michieltjampens/tios/core/datasheets/BLM series.jpg

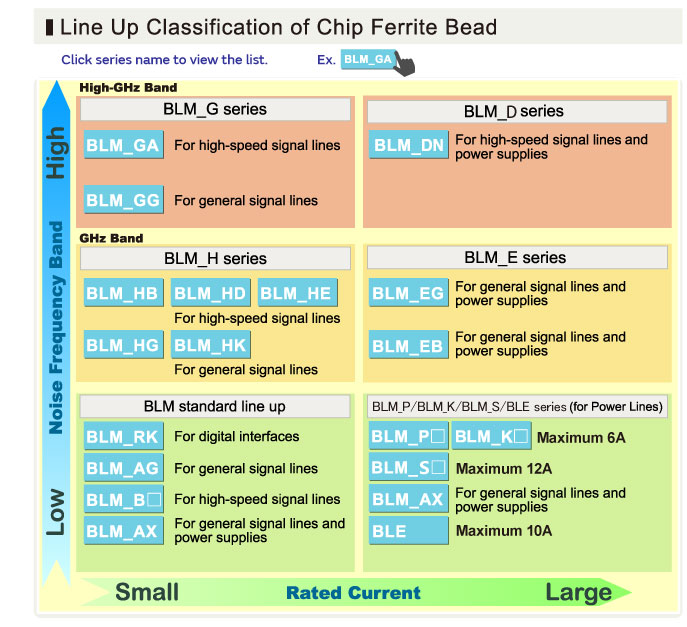
core/datasheets/BLM series.jpg
