michieltjampens/tios/core/corev2_rev0/core V2 rev0.png

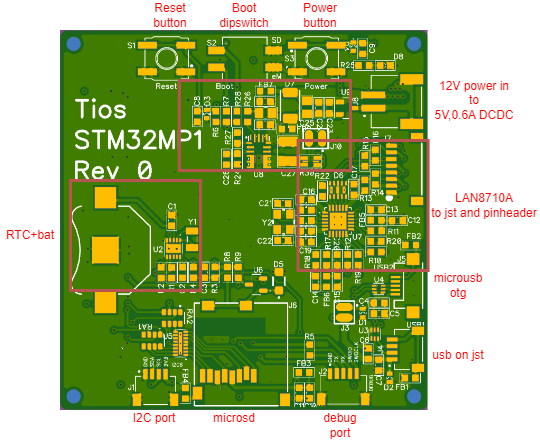
core/corev2_rev0/core V2 rev0.png
