michieltjampens/tios/core/bom_rev3.ods

Manufacturer name | Value | Name | Pattern | # | Mouser | Farnell | RefDes | 1 | 5 | 10 | 100 | Total 1 | Total 5 | Total 10 | Aisler
MYC-Y6ULY2-V2-4E512D-50-IC | imx6ull,512MB/4GB | MYC-Y6ULY2-V2 Split | MYCY6ULY2V24E512D50I | 1 | 885-CY6V24E512D50C |  | IC1 | 32,5 |  |  |  | 32,5 | 162,5 | 325 | x
ICP-20100 |  | ICP-20100 | PQFN50P200X200X85-10N | 1 |  | 3929880 | U7 | 3,98 |  | 3,11 |  | 3,98 | 19,9 | 31,1 | x
ESP-C3-13U |  | ESP-C3-13U | ESP-C3-13U | 1 |  |  | U2 | 4 | 3,24 | 3 |  | 4 | 16,2 | 30
MPM3833CGRH-Z |  | MPM3833 | QFN_2p5x3p5x1p6_MNP | 1 |  | 3818579 | U4 | 2,66 |  | 2,38 |  | 2,66 | 13,3 | 23,8 | x
CP2102N-A02-GQFN20 |  | CP2102N | IC_CP2102N-A01-GQFN20 | 1 |  |  | U1 | 2,4 |  | 2,35 |  | 2,4 | 12 | 23,5 | x
SHTC1-TR-1KS |  | SHTC1 | XDCR_SHTC1 | 1 | 403-SHTC1 | 3804223 | U9 | 3,09 |  | 2,26 |  | 3,09 | 11,3 | 22,6 | x
PCF85263ATL/AX |  | PCF85263ATL/AX | PCF85263ATL/AX | 1 | 771-PCF85263ATL/AX |  | U3 | 1,61 |  | 1,38 |  | 1,61 | 8,05 | 13,8 | x
ECLAMP2410PQTCT |  | EClamp2410P | SLP4016P16 | 1 | 947-ECLAMP2410P.TCT |  | U8 | 1,59 |  | 1,43 |  | 1,59 | 7,15 | 14,3 | x
BSR802NL6327HTSA1 |  | N Mos 20V/3,6A/17mR | SOT91P240X110-3N | 2 | 726-BSR802NL6327HTSA | 2212883 | U6, U10 |  | 0,75 | 0,65 |  | 3,76 | 6,46 | 12,92 | x
TPD2EUSB30DRTR | TPD2EUSB30 | 2-Ch ESD Protection | SOTFL35P100X50-3N | 2 |  | 3116502 | D1, D2 |  | 0,56 |  |  | 2,81 | 5,62 | 11,24 | x
USB3100-30-A | USB3100-XX-X_REVB | USB Micro Type B Rev | GCT_USB3100-XX-X_REVB | 2 | 640-USB3100-30-A | 2443125 | J1, J3 | 0,7 |  | 0,55 |  | 1,4 | 5,54 | 11,08 | x
MEM2061-01-188-00-A |  | MEM2061-01-188-00-A_REVA | GCT_MEM2061-01-188-00-A_REVA | 1 |  | 2678544 | J9 | 1,08 | 1,08 | 0,87 |  | 1,08 | 5,4 | 8,7 | x
3000TR |  | 3000TR | BAT_3000TR | 1 | 534-3000TR |  | BT1 | 0,8 | 0,80 | 0,80 |  | 0,8 | 4 | 8 | x
CM7V-T1A-32.768kHz-7pF-10PPM-TA-QC T3 (https://www.mouser.be/ProductDetail/Micro-Crystal/CM7V-T1A-32.768kHz-7pF-10PPM-TA-QC-T3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) | 32.768kHz | RTC Xtal | XTAL_CM7V-T1A_LOW_ESR | 1 | 428-201563-MG03 |  | Y1 | 0,788 |  | 0,698 |  | 0,788 | 3,94 | 6,98 | x
C2012X5R1A226M085AC | 22uF_10_20% | CAP_0805_22uF_10V | 0805 | 5 |  | 3581375 | C7, C8, C15, C18, C26 |  |  | 0,14 |  | 1,35 | 3,38 | 6,75 | x
DLP11SA900HL2L |  | DLP11SA900HL2L | DLP_0504_EXP | 2 |  | 2470369 | L1, L2 |  | 0,33 |  |  | 1,63 | 3,26 | 6,52 | x
EVQ-9P701P |  | SPST horizontal SMD switch | SW_EVQ-9P701P | 2 | 667-EVQ-9P701P |  | S1, S2 | 0,33 |  | 0,32 |  | 0,66 | 3,15 | 6,3 | x
PTVS3V3S1UR,115 | PTVS3V3S1UR | TVS Diode 3V3 Uni | SOD-123F | 1 |  | 1829253 | D6 |  | 0,48 | 0,39 |  | 2,42 | 2,42 | 3,94 | x
TCK106AF,LF |  | TCK106AF | SOT-25-5 | 1 | 757-TCK106AFLF | 3872359 | U5 |  | 0,44 | 0,36 |  | 2,18 | 2,18 | 3,6 | x
CL21B106KOQNNNE | 10uF_16V_10% | CAP_0805_10uF_16V | 0805 | 3 |  | 3013485 | C11, C14, C17 |  | 0,14 | 0,12 |  | 0,72 | 1,74 | 3,48 | x
YC164-JR-0722RL | 4x22R_5% | RES_ARRAY_22R_5% | RESCAXE80P320X160X70-8N | 18 |  | 9234411 |  |  |  | 0,04 | 0,018 | 0,74 | 1,8 | 3,24
MC0603B104K160CT | 100nF_16V_10% | CAP_0603_100nF_16V | 0603 | 6 |  | 1759016 | C2, C3, C4, C10, C13, C16 |  |  | 0,05 |  | 0,51 | 1,52 | 3,04 | x
150060RS75000 (https://be.farnell.com/wurth-elektronik/150060rs75000/led-0603-red-250mcd-625nm/dp/2322071?st=150060rs75000) | 630nm | 0603 LED Red | 0603 led | 2 |  | 2322071 | D4, D5 |  | 0,15 |  |  | 0,73 | 1,45 | 2,9 | x
EMK107ABJ475KA-T | 4.7uF_16V_10% | CAP_0603_4.7uF_16V | 0603 | 2 |  | 2112741 | C1, C19 |  |  | 0,14 |  | 1,4 | 1,4 | 2,8 | x
0402B104K160CT | 100nF_16V_10% | CAP_0402_100nF_16V | 0402 | 4 |  | 2496771 | C20, C23, C24, C25 |  |  | 0,062 |  | 0,62 | 1,24 | 2,48
SMAJ5.0CA/TR7 | SMAJ5.0CA | TVS Diode 5V | DIOM4325X250N | 1 |  | 2675312 | D3 |  | 0,29 | 0,23 |  | 1,43 | 1,43 | 2,29
MFU0603FF02000P100 | 2A | 2A Fuse 32V max | 0603 | 1 |  | 2057168 | F1 | 0,203 |  |  |  | 0,20 | 1,02 | 2,03
BLM18PG330SN1D | BLM18PG330SN1D | Ferrite 33R@100MHz | 0603 | 3 |  | 1515742 | FB3, FB5, FB6 |  |  | 0,063 |  | 0,63 | 0,95 | 1,89
HI0805P390R-10 | 39R@100MHz, 4A, HI, 8mR | HI0805P390R-10 | 0805 | 2 |  | 3605009 | E1, E2 |  |  | 0,078 |  | 0,78 | 0,78 | 1,55
0603YD105KAT2A | 1uF_16V_10% | CAP_0603_1uF_16V | 0603 | 3 |  | 1327680 | C9, C12, C21 |  |  | 0,047 |  | 0,47 | 0,71 | 1,41
MC0603N470J500CT | 47pF_50V_5% | CAP_0603_47pF_50V | 0603 | 2 |  | 1759062 | C5, C6 |  |  | 0,045 |  | 0,45 | 0,452 | 0,90
BLM18EG221SN1D | 220R@100MHz | Murata BLM18EG221SN1D ferrite | 0603 | 1 |  | 1515716 | FB4 |  |  | 0,084 |  | 0,84 | 0,84 | 0,84
BLM18PG121SN1D | 2A/0.05DCR | FB 2A | 0603 | 2 |  | 1515738 | FB1, FB2 |  |  | 0,032 |  | 0,32 | 0,32 | 0,64
C1608X7R1H103K080AA | 10nF_50V_10% | CAP_0603_10nF_50V | 0603 | 1 |  | 1907315 | C22 |  |  | 0,057 |  | 0,57 | 0,57 | 0,57
MCWR06X2212FTL | 22k1_1% | RES_0603_22k1_1% | 0603 | 1 |  | 2694776 | R1
MCMR06X1001FTL | 1k_1% | RES_0603_1k_1% | 0603 | 3 |  | 2073348 | R2, R4, R5
MCSR06X22R0FTL | 22R_1% | RES_0603_22R_1% | 0603 | 2 |  | 2074219 | R6, R8
MCWR06X1002FTL | 10k_1% | RES_0603_10k_1% | 0603 | 1 |  | 2447230 | R7
MCWR06X4701FTL | 4k7_1% | RES_0603_4k7_1% | 0603 | 2 |  | 2447385 | R9, R13
MCWR04X2003FTL | 200k_1% | RES_0603_200k_1% | 0603 | 1 |  | 2447131 | R10
MCWR06X1003FTL | 100k_1% | RES_0603_100k_1% | 0603 | 4 |  | 2447226 | R11, R12, R16, R17
CRCW060344K2FKEA. | 44k2_1% | RES_0603_44k2_1% | 0603 | 2 |  | 2138466 | R3,R14
S1751-46R |  | Ground clip | Hawin S1751-46R Ground clip | 1 | 855-S1751-46R | 2293786 | TP2
 |  |  |  |  |  |  |  |  |  |  |  | 81,1 | 311,9 | 600,2
 |  |  |  |  |  |  |  |  |  |  |  | 81,1 | 62,4 | 60,02
 |  |  |  | 93 |  |  |  |  |  |  |  | 5 | 4,5 | 3,8
 |  |  |  |  |  |  |  |  |  |  | Each | 86,1 | 66,9 | 63,8
 |  |  |  |  |  |  |  |  |  |  | PCB | 103 | 80 | 76
