michieltjampens/tios/hardware/bom.ods

# | RefDes | Name | Manufacturer | Manufacturer name | Mouser | Quantity | Price/1 | Price/10 | Price/100 |  | 1 Board | 10 | Cost | Cost 100
1 | C1, C6, C7, C8, C9, C10, C12, C13, C14, C15, C17, C18, C21, C25, C29, C33, C37, C40, C45, C46, C47, C48, C53, C55, C56, C57, C58, C59, C61, C62, C63, C65, C66, C76 | CAP_0402_100nF_16V | Walsin | 0402B104K160CT | 791-0402B104K160CT | 34 | 0,108 | 0,017 | 0,01 |  | 0,578 | 340 | 3,4 |  | 1,35%
2 | C2, C38 | CAP_0402_2.2uF_6V3 | Taiyo Yuden | MSASJ105SB5225KF | 963-MSASJ105SB5225KF | 2 | 0,093 | 0,032 | 0,017 |  | 0,186 | 20 | 0,64 | 1,7 | 0,25%
3 | C3, C4, C20, C49 | CAP_0402_1nF_50V | Taiyo Yuden | MBASU105SB7102KFNA18 | 963-MBASU105SB7102KF | 4 | 0,093 | 0,025 | 0,013 |  | 0,372 | 40 | 1 | 1,3 | 0,40%
4 | C5, C11, C64 | CAP_0603_10uF_10V | Murata | GRM188R61A106ME69D | 81-GRM188R61A106ME9D | 3 | 0,13 | 0,048 | 0,028 |  | 0,39 | 30 | 1,44 | 2,8 | 0,57%
5 | C16, C19 | CAP_0402_4.7uF_6V3 | Samsung | CL05A475KQ5NRNC | 187-CL05A475KQ5NRNC | 2 | 0,093 | 0,03 | 0,02 |  | 0,186 | 20 | 0,6 | 2 | 0,24%
6 | C22, C26, C30, C34 | CAP_0603_10uF_16V | Kyocera AVX | CM105X5R106K16AT | 581-CM105X5R106K16AT | 4 | 0,223 | 0,104 | 0,062 |  | 0,892 | 40 | 4,16 | 6,2 | 1,65%
7 | C23, C27, C31, C35 | CAP_0402_3.6pF_25V | muRata | GRM1555C1E3R6BA01D | 81-GRM1555C1E3R6BA1D | 4 | 0,093 | 0,047 | 0,021 |  | 0,372 | 40 | 1,88 | 2,1 | 0,74%
8 | C24, C28, C32, C36, C60 | CAP_0603_22uF_6V3 | Murata | GRM188R60J226MEA0D | 81-GRM188R60J226ME0D | 5 | 0,14 | 0,057 | 0,04 |  | 0,7 | 50 | 2,85 | 4 | 1,13%
9 | C39, C67, C68, C69, C70, C72 | CAP_0402_1uF_16V | Taiyo Yuden | MCASE105SB5105KFNA01 | 963-MCASE105SB5105KF | 6 | 0,093 | 0,033 | 0,017 |  | 0,558 | 60 | 1,98 | 1,7 | 0,78%
10 | C41, C42 | CAP_0402_16pF_50V | Yageo | CC0402JRNPO9BN160 | 603-CC402JRNPO9BN160 | 2 | 0,093 | 0,02 | 0,011 |  | 0,186 | 20 | 0,4 | 1,1 | 0,16%
11 | C43, C44 | CAP_0402_30pF_25V | Walsin | 0402N300J250CT | 791-0402N300J250CT | 2 | 0,108 | 0,016 | 0,009 |  | 0,216 | 20 | 0,32 | 0,9 | 0,13%
12 | C50, C52, C54 | CAP_0603_22uF_10V | Murata | GRM188R61A226ME15J | 81-GRM188R61A226ME5J | 3 | 0,186 | 0,124 | 0,062 |  | 0,558 | 30 | 3,72 | 6,2 | 1,47%
13 | C51 | CAP_0402_2.2nF_25V | Murata | GRM155R61E222KA01D | 81-GRM155R61E222KA1D | 1 | 0,093 | 0,017 | 0,007 |  | 0,093 | 10 | 0,17 | 0,7 | 0,07%
14 | C71, C74, C75 | CAP_0402_10nF_25V | Walsin | MG15B103K250CT | 791-MG15B103K250CT | 3 | 0,108 | 0,01 | 0,005 |  | 0,324 | 30 | 0,3 | 0,5 | 0,12%
15 | C73 | CAP_0402_470nF_16V | Taiyo Yuden | EMK105ABJ474KV-F | 963-EMK105ABJ474KV-F | 1 | 0,102 | 0,044 | 0,022 |  | 0,102 | 10 | 0,44 | 2,2 | 0,17%
16 | D1 | ESD Suppressor USB | ST | ESDA7P120-1U1M | 511-ESDA7P120-1U1M | 1 | 0,4 | 0,273 | 0,188 |  | 0,4 | 10 | 2,73 | 18,8 | 1,08%
17 | ED1, ED2, ED3, ED4, ED5 | ESD 0402 3V3 | NXP | PESD3V3L1BSL | 771-PESD3V3L1BSLZ | 5 | 0,093 | 0,07 | 0,038 |  | 0,465 | 50 | 3,5 | 3,8 | 1,39%
18 | FB1, FB2 | Ferrite 120R@100MHz, 2A | muRata | BLM18PG121SN1D | 81-BLM18PG121SN1D | 2 | 0,167 | 0,137 | 0,076 |  | 0,334 | 20 | 2,74 | 7,6 | 1,08%
19 | FB3 | Ferrite 220R@100MHz, 2A | Murata | BLM18EG221SN1D | 81-BLM18EG221SN1D | 1 | 0,195 | 0,11 | 0,099 |  | 0,195 | 10 | 1,1 | 9,9 | 0,44%
20 | FB4, FB5, FB6 | Ferrite 33R@100MHz, 3A | Murata | BLM18PG330SN1D | 81-BLM18PG330SN1D | 3 | 0,093 | 0,06 | 0,033 |  | 0,279 | 30 | 1,8 | 3,3 | 0,71%
21 | J1 | USB Micro Type B Rev | GCT | USB3100-30-A | 640-USB3100-30-A | 1 | 0,651 | 0,492 | 0,431 |  | 0,651 | 10 | 4,92 | 43,1 | 1,95%
22 | J2 | tiny usd slot | Molex | 47571-0001 | 538-47571-0001 | 1 | 0,632 | 0,558 | 0,558 |  | 0,632 | 10 | 5,58 | 55,8 | 2,21%
26 | L1, L2, L3, L4 | DFE252012F-1R0M=P2 | muRata | DFE252012F-1R0MP2 | 81-DFE252012F-1R0MP2 | 4 | 0,316 | 0,206 | 0,196 |  | 1,264 | 40 | 8,24 | 19,6 | 3,26%
27 | R1, R39, R40, R54 | RES_0402_100R_1% | Yageo | RC0402FR-7W100RL | 603-RC0402FR-7W100RL | 4 | 0,093 | 0,015 | 0,007 |  | 0,372 | 40 | 0,6 | 0,7 | 0,24%
28 | R2, R10, R14, R17, R20, R23, R24, R26, R28, R41, R42, R51, R52, R55, R59, R60 | RES_0402_10k_1% | Yageo | RC0402FR-0710KL | 603-RC0402FR-0710KL | 16 | 0,093 | 0,008 | 0,005 |  | 0,128 | 160 | 1,28 |  | 0,51%
29 | R3 | RES_0402_240R_1% | Walsin | WR04X2400FTL | 791-WR04X2400FTL | 1 | 0,108 | 0,008 | 0,003 |  | 0,108 | 10 | 0,08 | 0,3 | 0,03%
30 | R4, R5, R11 | RES_0402_1k_1% | Yageo | RC0402FR-101KL | 603-RC0402FR-101KL | 3 | 0,093 | 0,008 | 0,005 |  | 0,279 | 30 | 0,24 | 0,5 | 0,09%
31 | R6, R18 | RES_0402_124k_1% | Yageo | RC0402FR-07124KL | 603-RC0402FR-07124KL | 2 | 0,093 | 0,008 | 0,005 |  | 0,186 | 20 | 0,16 | 0,5 | 0,06%
32 | R7, R25, R31, R32, R33, R34, R35, R36, R50, R53 | RES_0402_22R_1% | Walsin | WR04X22R0FTL | 791-WR04X22R0FTL | 10 | 0,108 | 0,006 | 0,003 |  | 0,06 | 100 | 0,3 | 0,3 | 0,12%
33 | R8, R9, R13, R16, R19, R22 | RES_0402_100k_1% | Yageo | RC0402FR-13100KL | 603-RC0402FR-13100KL | 6 | 0,093 | 0,008 | 0,005 |  | 0,558 | 60 | 0,48 | 0,5 | 0,19%
34 | R12, R21 | RES_0402_66k5_1% | Yageo | AC0402FR-0766K5L | 603-AC0402FR-0766K5L | 2 | 0,093 | 0,011 | 0,007 |  | 0,186 | 20 | 0,22 | 0,7 | 0,09%
35 | R15 | RES_0402_453k_1% | Yageo | RC0402FR-07453KL | 603-RC0402FR-07453KL | 1 | 0,093 | 0,008 | 0,005 |  | 0,093 | 10 | 0,08 | 0,5 | 0,03%
36 | R27 | RES_0402_0R | Vishay | CRCW04020000Z0EDC | 71-CRCW04020000Z0EDC | 1 | 0,093 | 0,012 | 0,007 |  | 0,093 | 10 | 0,12 | 0,7 | 0,05%
37 | R29, R30 | RES_0402_1R_1% | Walsin | WR04W1R00FTL | 791-WR04W1R00FTL | 2 | 0,108 | 0,01 | 0,004 |  | 0,216 | 20 | 0,2 | 0,4 | 0,08%
38 | R37, R38 | RES_0402_10R_1% | Yageo | AC0402FR-0710RL | 603-AC0402FR-0710RL | 2 | 0,093 | 0,013 | 0,07 |  | 0,186 | 20 | 0,26 | 7 | 0,10%
39 | R43 | RES_0402_12k_1% | Yageo | RC0402FR-0712KL | 603-RC0402FR-0712KL | 1 | 0,093 | 0,008 | 0,005 |  | 0,093 | 10 | 0,08 | 0,5 | 0,03%
40 | R44 | RES_0402_1k5_1% | Walsin | WR04X1501FTL | 791-WR04X1501FTL | 1 | 0,108 | 0,006 | 0,003 |  | 0,108 | 10 | 0,06 | 0,3 | 0,02%
41 | R45 | RES_0402_33R_1% | Yageo | RC0402FR-0733RL | 603-RC0402FR-0733RL | 1 | 0,093 | 0,008 | 0,005 |  | 0,093 | 10 | 0,08 | 0,5 | 0,03%
42 | R46, R47, R48, R49 | RES_0402_49R9_1% | Vishay | RCC040249R9FKED | 71-RCC040249R9FKED | 4 | 0,102 | 0,051 | 0,023 |  | 0,408 | 40 | 2,04 | 2,3 | 0,81%
43 | R56, R57 | RES_0402_470R_1% | TE Connectivity | CRGCQ0402F470R | 279-CRGCQ0402F470R | 2 | 0,093 | 0,013 | 0,006 |  | 0,186 | 20 | 0,26 | 0,6 | 0,10%
44 | R58, R62, R63 | RES_0402_133R_1% | Yageo | RC0402FR-07133RL | 603-RC0402FR-07133RL | 3 | 0,093 | 0,008 | 0,005 |  | 0,279 | 30 | 0,24 | 0,5 | 0,09%
45 | R61 | RES_0402_18k_1% | Yageo | RC0402JR-1318KL | 603-RC0402JR-1318KL | 1 | 0,093 | 0,014 | 0,007 |  | 0,093 | 10 | 0,14 | 0,7 | 0,06%
49 | U2 | EMMC16G-MW28-01E10 | Kingston Technology | EMMC16G-MW28-01E10 | 524-EMMC16GMW2801E10 | 1 | 5,82 | 5,79 | 5,79 |  | 5,82 | 10 | 57,9 |  | 22,92%
50 | U3 | 4Gb DDR3L ram | Kingston | D2516ECMDXGJDI-U | 524-D2516ECMDXGJDI-U | 1 | 2,88 | 2,86 | 2,86 |  | 2,88 | 10 | 28,6 |  | 11,32%
51 | U4, U7 | TPS62A02 | Texas Instruments | TPS62A02DRLR | 595-TPS62A02DRLR | 2 | 0,409 | 0,303 | 0,19 |  | 0,818 | 20 | 6,06 |  | 2,40%
52 | U5 | usd esd pu | Semtech | ECLAMP2410PQTCT | 947-ECLAMP2410P.TCT | 1 | 1,26 | 1,05 | 0,839 |  | 1,26 | 10 | 10,5 |  | 4,16%
53 | U6 | N-Channel 20V 3.7A | Infineon | BSR802NL6327HTSA1 | 726-BSR802NL6327HTSA | 1 | 0,512 | 0,445 | 0,327 |  | 0,512 | 10 | 4,45 |  | 1,76%
54 | U8, U9 | TPS62A01 | Texas Instruments | TPS62A01DRLR | 595-TPS62A01DRLR | 2 | 0,409 | 0,3 | 0,171 |  | 0,818 | 20 | 6 |  | 2,37%
55 | U10 | TLV75518PDBVR | Texas Instruments | TLV75518PDBVR | 595-TLV75518PDBVR | 1 | 0,372 | 0,296 | 0,22 |  | 0,372 | 10 | 2,96 |  | 1,17%
56 | U11 | LAN8720A-CP | Microchip | LAN8720A-CP-TR-ABC | 579-LAN8720ACPTRABC | 1 | 1,2 | 1,2 | 1,2 |  | 1,2 | 10 | 12 |  | 4,75%
57 | U12, U13 | USB2 ESD+Choke | ST | ECMF02-2AMX6 | 511-ECMF02-2AMX6 | 2 | 0,484 | 0,348 | 0,25 |  | 0,968 | 20 | 6,96 |  | 2,75%
58 | Y1 | 24MHz 18pF | ECS | ECS-240-18-33B-7KM-TR | 520-240-18-33B-7KM-T | 1 | 0,288 | 0,242 | 0,242 |  | 0,288 | 10 | 2,42 |  | 0,96%
59 | Y2 | 25MHz XTAL | ECS | ECS-250-8-33B-CKM | 520-ECS250833BCKM-TR | 1 | 0,428 | 0,318 | 0,283 |  | 0,428 | 10 | 3,18 |  | 1,26%
60 | U1 | RK3308B | Rockchip | RK3308B |  | 1 | 5,08 | 5,08 | 5,08 |  | 5,08 | 10 | 50,8 |  | 20,11%
 |  |  |  |  |  |  |  |  |  | Total | € 34,10 |  | € 252,66
 |  |  |  |  |  |  |  |  |  | Per Board | € 34,10 |  | € 25,27
