michieltjampens/tios/(threads)

Thread 1 (2022-07-17):

Rev 2 Testing

michieltjampens, 2022-07-17:
**Build Rev 2**
- [x] Received board (eta 27/7/2022)
- [ ] Order new components (sensors & caps)
- [ ] PCBA all 94 components... (hurray for stencil + heated build plate + paste)

**Test prep (assumes that stuff working in rev1 still work)**
- [x] Install u-boot,kernel and rootfs via usb client

**Component testing**
- [x] Check if USB->UART works
- [ ] Check if µSD issue is fixed
- [ ] Check if RTC works on battery (waiting for delivery)
- [x]  Check if temp/hum is found on bus
  - [x] Write dcafs code for it
- [x]  Check if temp/press is found on bus
  - [x] Alter DTS to include the int pin
  - [x] Write dcafs code for it
- [ ]  Check if SPI connection to ESP32-C3 works
  - [ ] Recompile kernel to add required support
  - [ ] Check if Wifi/BLE work
- [x]  Check if ethernet works (fec1)
- [ ] Check if USB host works

michieltjampens, 2022-08-10:
Burned out SoM on trying to remove the RTC...

Closed 2024-03-15.
