michieltjampens/tios/core/core_v1_schematic.pdf

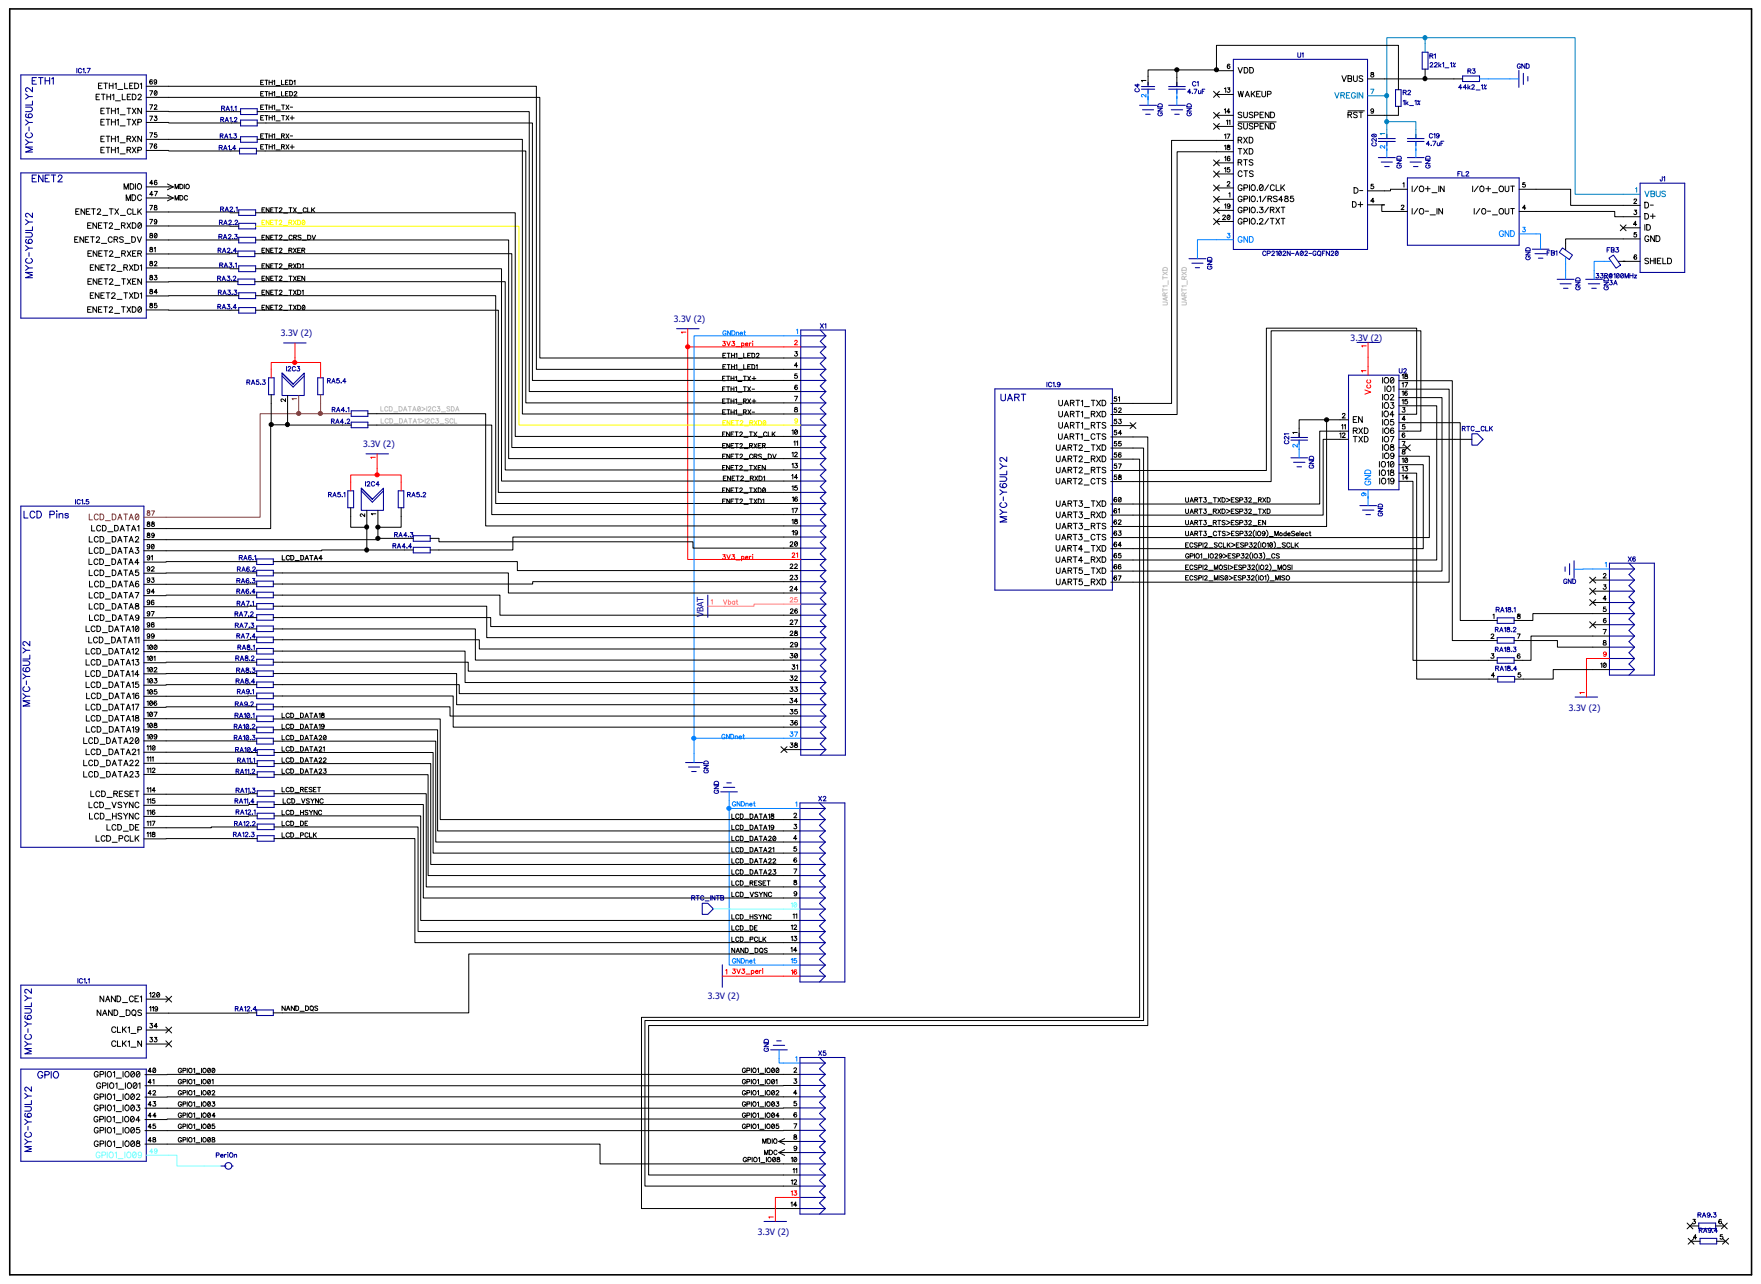
[picture p3: page 1]
VBAT

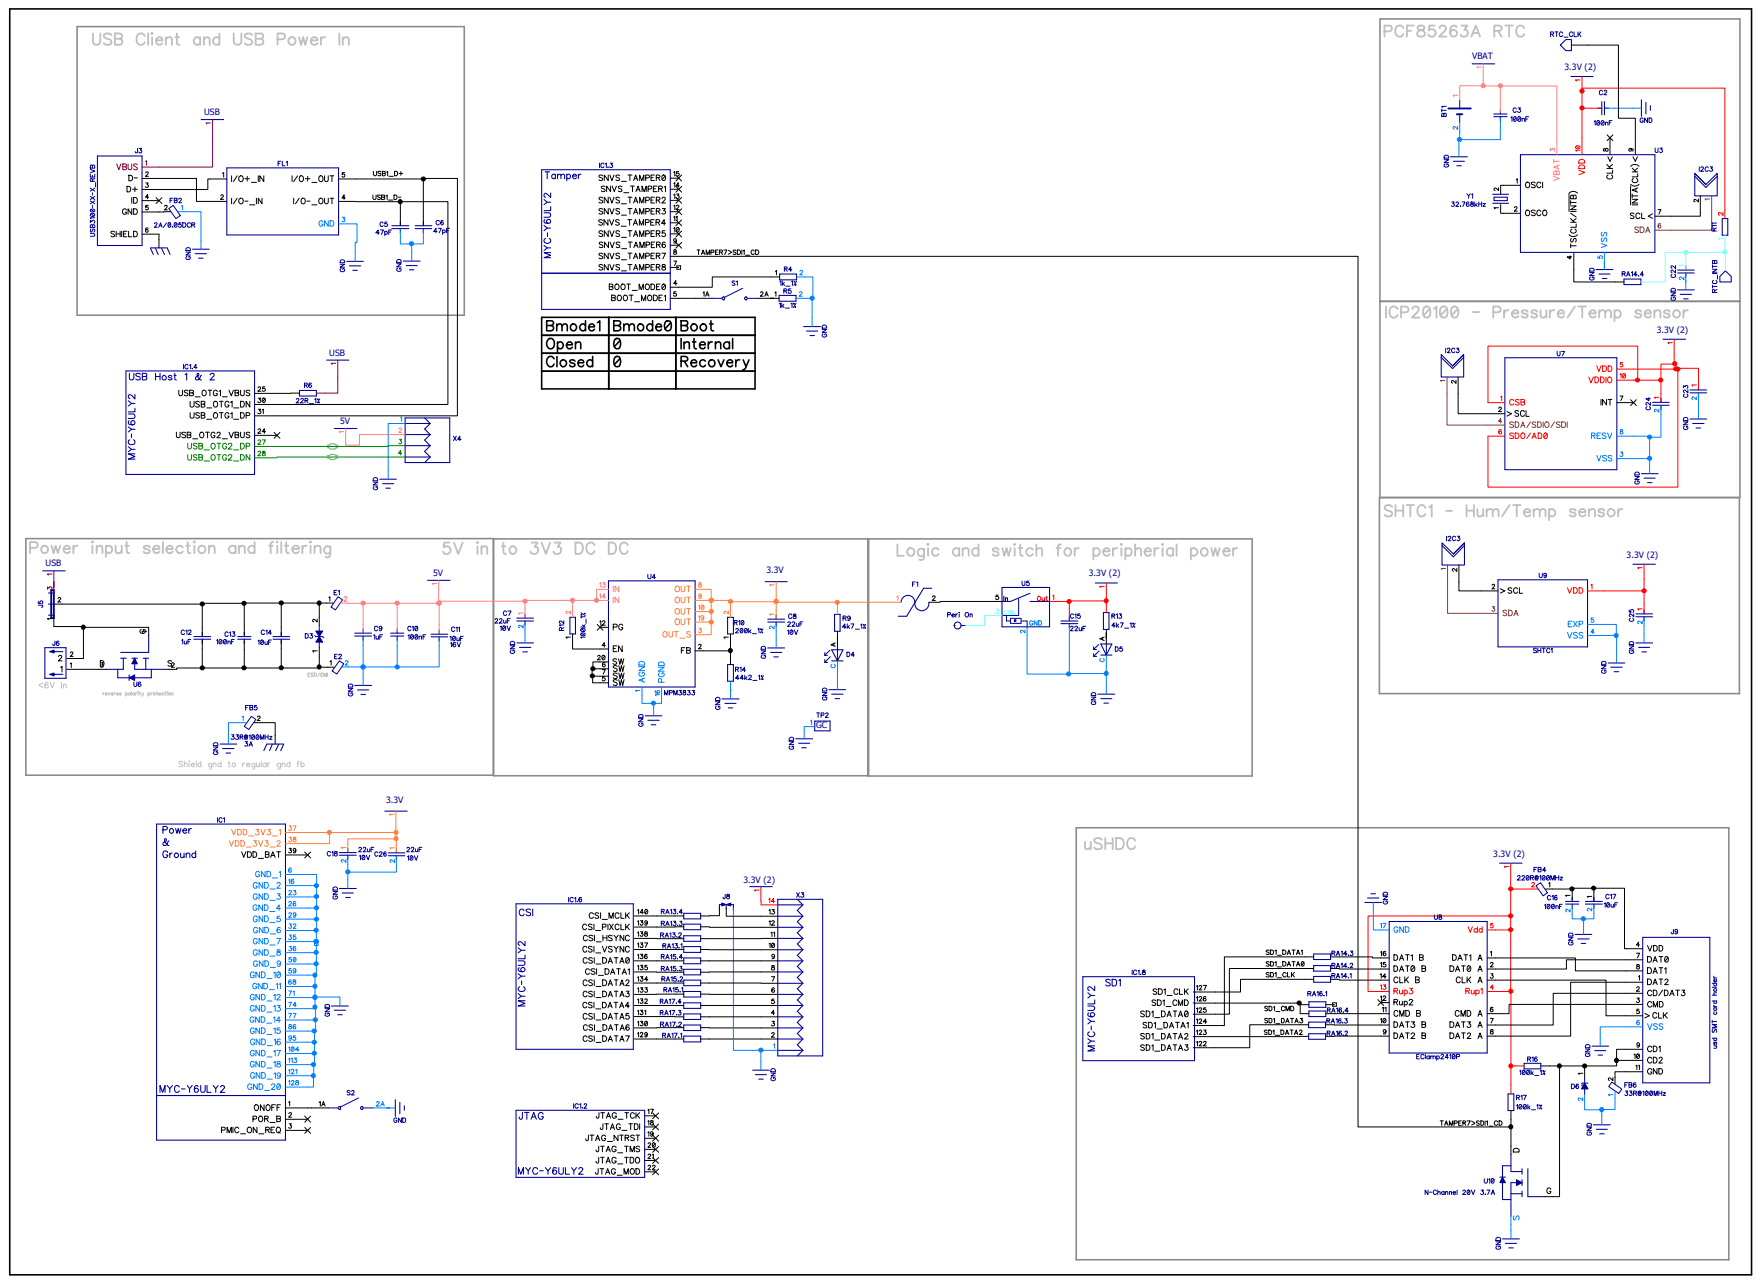
[picture p4: page 2]
VBAT; USB
