michieltjampens/tios/core/corev2_rev0/core_v2rev0_schematic.pdf

## VBAT

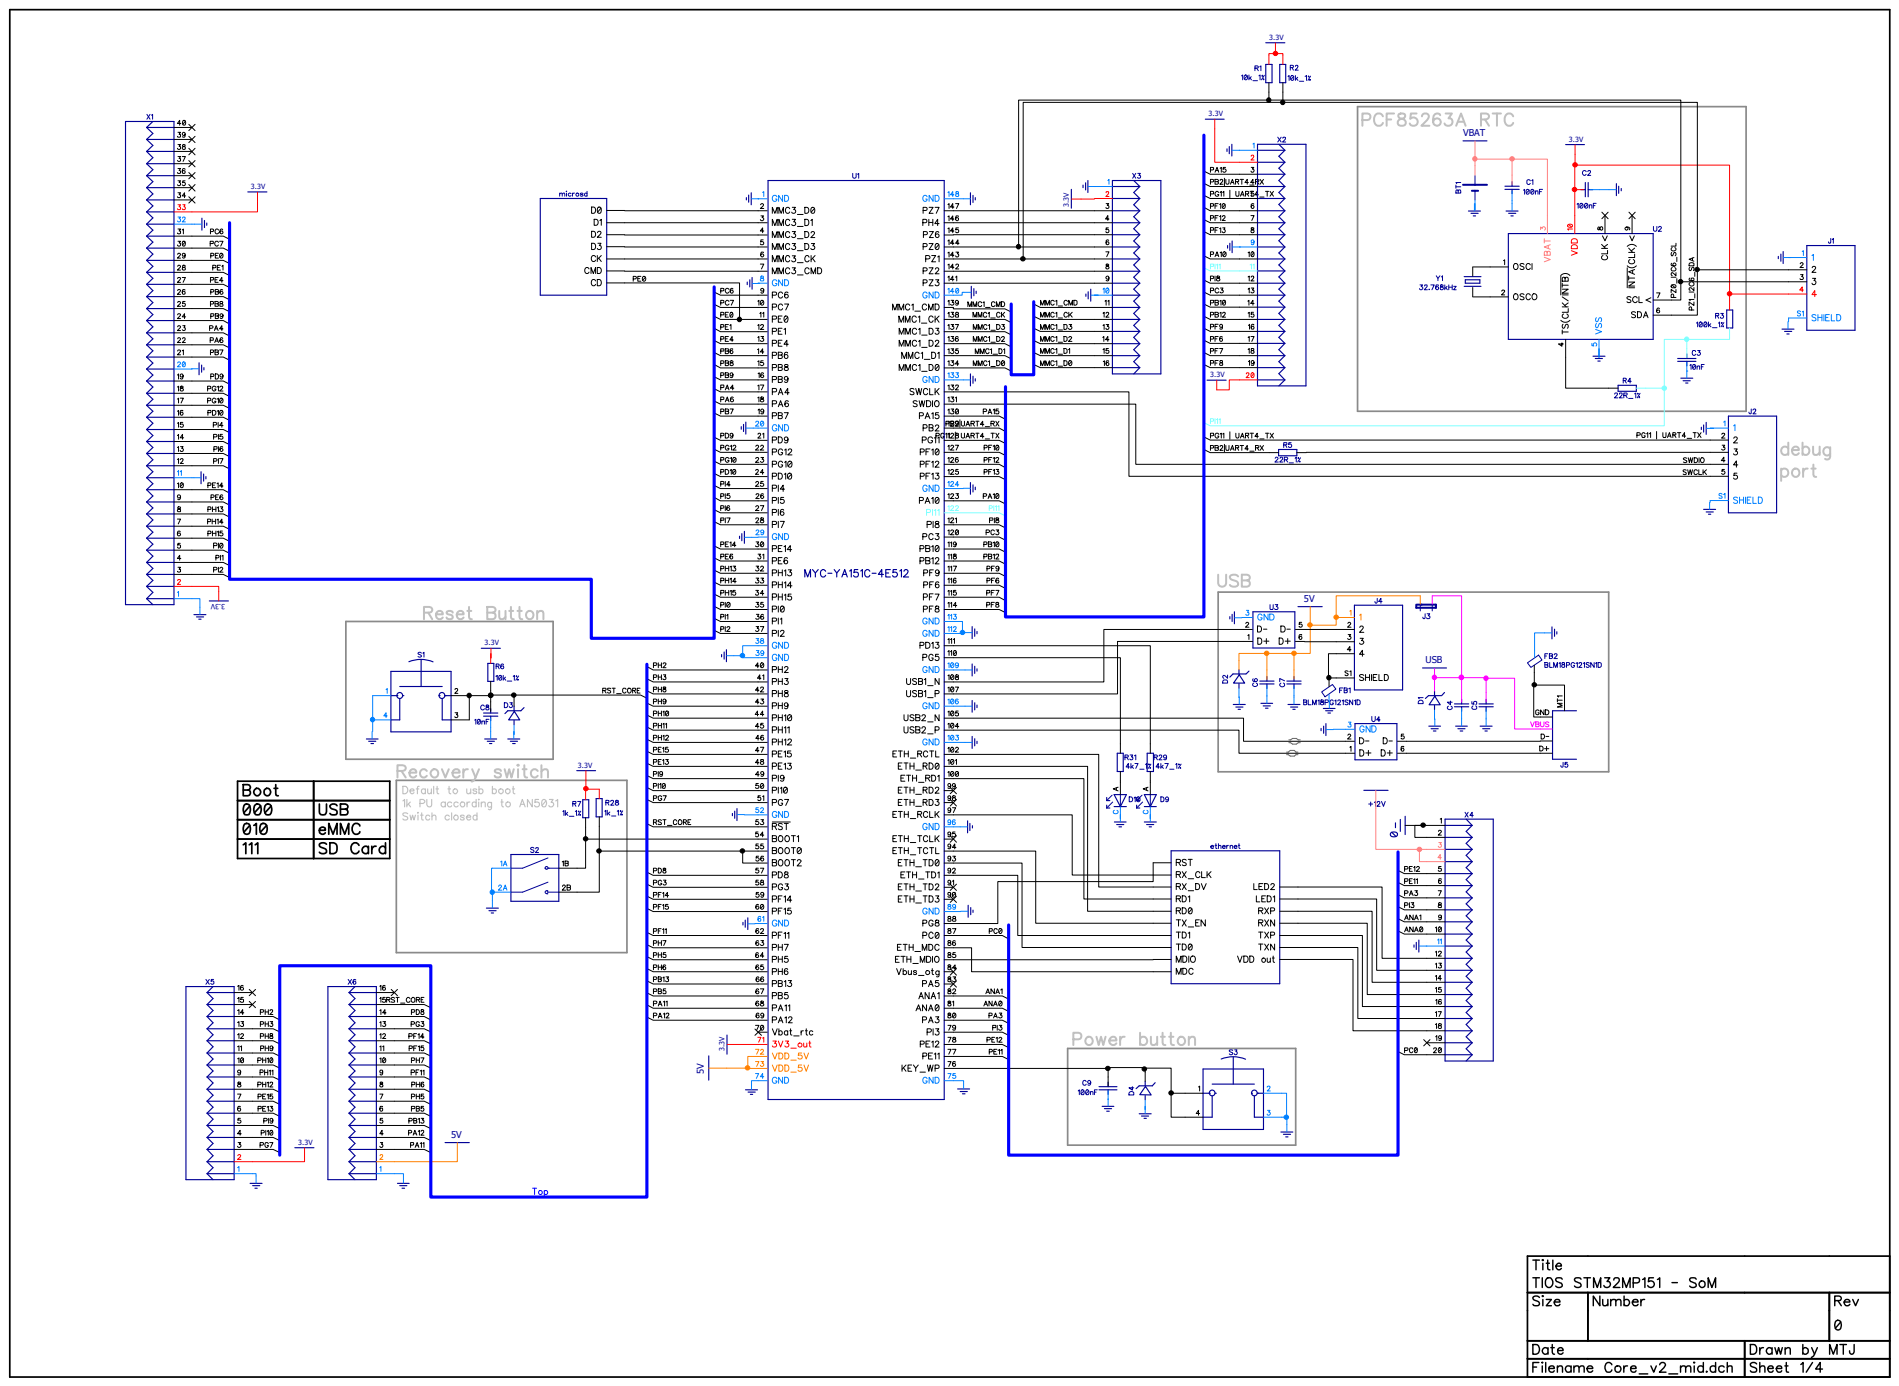
[picture p5: page 1]
USB

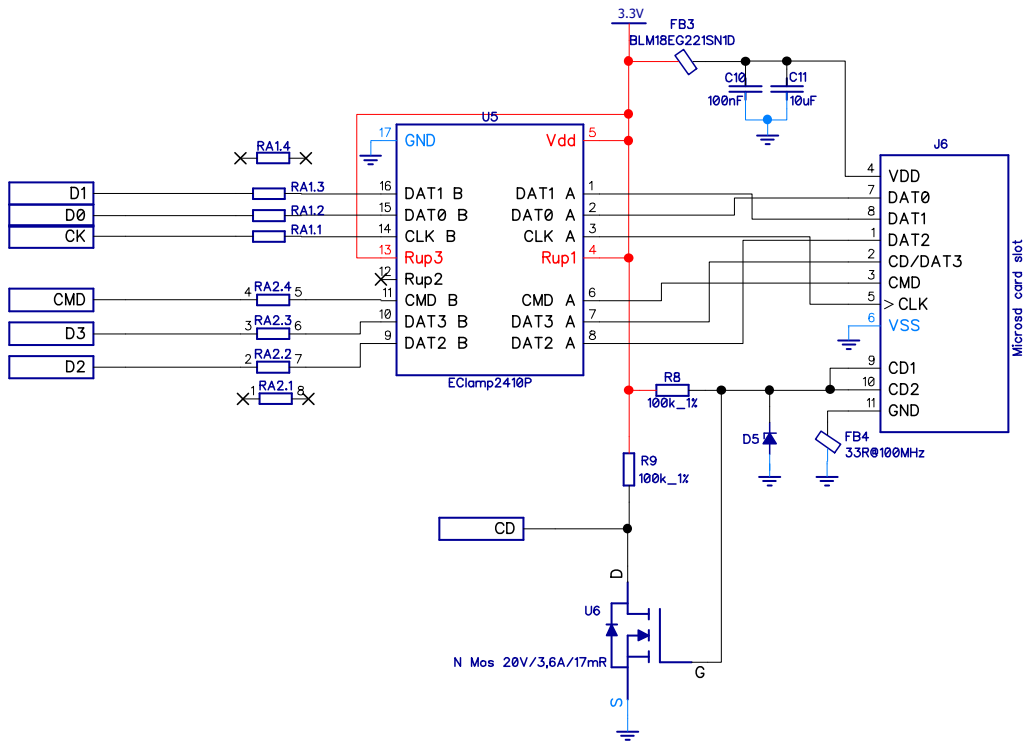
[picture p6: page 2]

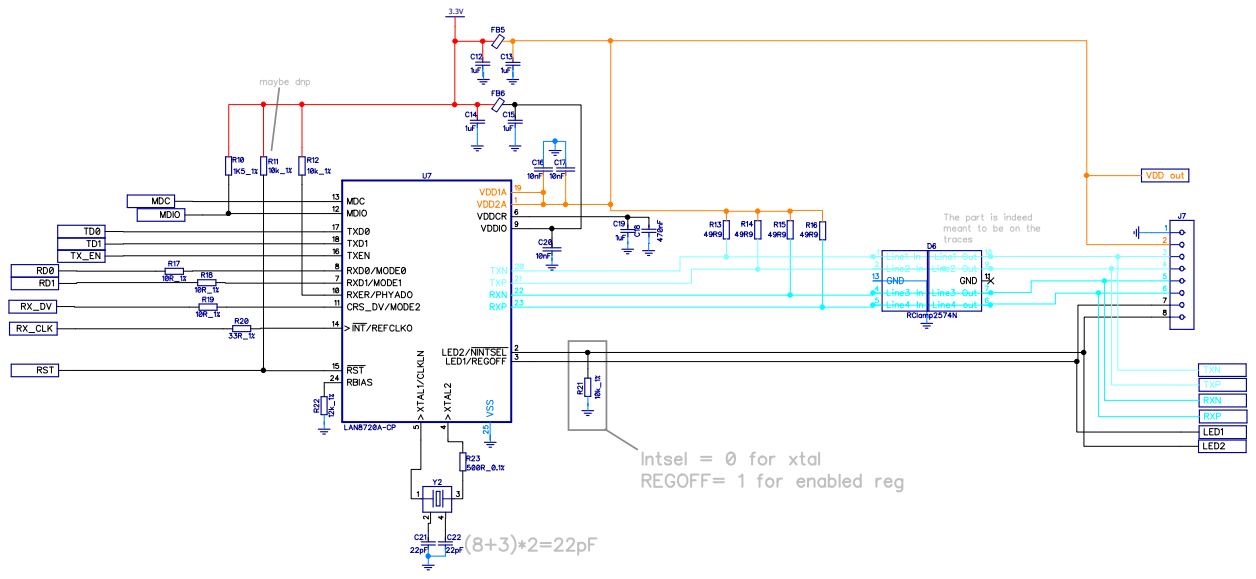
[picture p7: page 3]

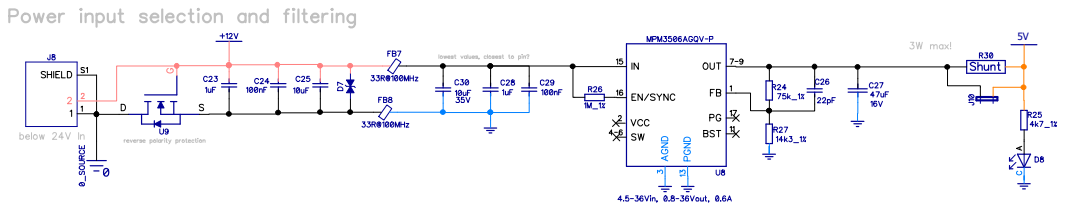
[picture p8: page 4]
