michieltjampens/tios/(list of files, drawings)

Other design files:
core/Core_v1.dch
core/Core_v1.dip
core/Core_v2.dip
core/corev2_rev0/Core_v2 - rev0.dch
core/corev2_rev0/Core_v2 - rev0.dip
hardware/tios v1.dch
hardware/tios v1.dip
