michieltjampens/tios/core/code/cubemx/tios.ioc

Mcu.UserName=STM32MP151AACx
PA1.Signal=ETH1_REF_CLK
PA10.Signal=USB_OTG_HS_ID
PA2.Signal=ETH1_MDIO
PA7.Signal=ETH1_CRS_DV
PA8.Signal=SDMMC2_D4
PA9.Signal=SDMMC2_D5
PB11.Signal=ETH1_TX_EN
PB15.Signal=SDMMC2_D1
PB2.Signal=UART4_RX
PB3.Signal=SDMMC2_D2
PB4.Signal=SDMMC2_D3
PC1.Signal=ETH1_MDC
PC10.Signal=SDMMC1_D2
PC14-OSC32_IN.Signal=RCC_OSC32_IN
PC15-OSC32_OUT.Signal=RCC_OSC32_OUT
PC4.Signal=ETH1_RXD0
PC5.Signal=ETH1_RXD1
PD0.Signal=I2C5_SDA
PD1.Signal=I2C5_SCL
PD3.Signal=SDMMC2_D7
PD7.Signal=SDMMC3_D3
PE3.Signal=SDMMC2_CK
PE5.Signal=SDMMC2_D6
PE6.Signal=SDMMC2_D0
PF0.Signal=SDMMC3_D0
PF1.Signal=SDMMC3_CMD
PF4.Signal=SDMMC3_D1
PF5.Signal=SDMMC3_D2
PG11.Signal=UART4_TX
PG13.Signal=ETH1_TXD0
PG14.Signal=ETH1_TXD1
PG15.Signal=SDMMC3_CK
PG6.Signal=SDMMC2_CMD
PH0-OSC_IN.Signal=RCC_OSC_IN
PH1-OSC_OUT.Signal=RCC_OSC_OUT
PI11.Signal=PWR_WKUP5
