michieltjampens/tios/(commit log)

2022-05-23 initial upload
    initial upload
    [8xRS232_No_Iso.dch, 8xRS232_no_iso.dip, BaseIO.dch, bom v0.ods, myir v0.dch, myir v0.dip, myir v0_1.dch, myir v0_1.dip]
2022-06-18 Started working on base (tentative name)
    [BaseIO.dch, perip.ods]
2022-07-03 updated
    added gnd attachment point, increased the width of some tracks
    [Core_v1.dch, Core_v1.dip]
2022-07-10 changed structure
    [Core_v1.dch, Core_v1.dip, MYC-Y6ULX Pin list_V13.xlsx, bom v0.ods, imximage.cfg]
2022-07-11 redrew power part
    [Core_v1.dch, Core_v1.dip, Core_v1b.dip]
2022-07-11 improved the i2c definitions
2022-07-12 USB to uart changes
    Changed cp2102n use to bus powered insterad of self powered, still need to add backfeed prevention.
    [Core_v1.dch]
2022-07-12 updated towards rev2
    [Core_v1.dch, Core_v1.dip, Core_v1b.dip]
2022-07-16 peri on
    [Core_v1.dch, Core_v1.dip]
2022-07-17 added temp/hum and temp/press sensors
    [Core_v1.dch, Core_v1.dip]
2022-07-17 connected int of temp/press
    [Core_v1.dch, Core_v1.dip]
2022-07-17 cleaned silk
    [Core_v1.dch, Core_v1.dip]
2022-07-19 minor modifications
    - increase 0.2 nets to 0.25 atleast
    - moved sensors to i2c3 from i2c4
    - reduced holesize of pinheaders (various sizes to test)
    - added more silkscreen
    -rerouted most of X1 to allow for easier split
    [Core_v1.dch, Core_v1.dip]
2022-07-20 to early
    [8xRS232_No_Iso.dch, 8xRS232_no_iso.dip, BaseIO.dch, baseIO.dip]
2022-07-21 swapped C17 for bigger package
    [Core_v1.dch, Core_v1.dip]
2022-07-22 tried to optimise the BOM count
    [Core_v1.dch, Core_v1.dip]
2022-07-22 swapped F1 with cheaper alternative
    [Core_v1.dch]
2022-07-24 started on the base board
    contains so far: usb host, ethernet, 24V -> 5V dcdc
    [Base_v1.dch, Base_v1.dip]
2022-07-24 cleanup & minor replacements
    [Core_v1.dch, Core_v1.dip]
2022-07-29 rev 3 changes
    [Core_v1.dch, Core_v1.dip, bom_rev3.ods]
2022-07-30 rev3 changes
    - Removed mask from BT1
    - Removed R7, J4, TP1 because not needed (were placed 'just in case'
    - Move RA16, RA14
    [Core_v1.dch, Core_v1.dip]
2022-07-30 resized holes of X components, some minor rerouting
    [Core_v1.dch, Core_v1.dip]
2022-07-31 Added controller
    [joystick-reader.dch]
2022-08-22 finished rev0 for joystick reader
    [joystick-reader.dch, joystick-reader.dip]
2022-08-22 res changes, pattern fixed
    changed resistors, fixed shtc pattern
    [Core_v1.dch, Core_v1.dip]
2022-08-22 added dcdc
    [Base_v1.dch, Base_v1.dip]
2022-08-28 silkscreen changes
    [joystick-reader.dip]
2022-09-09 cleanup
    cleanup
    [joystick-reader.dch, joystick-reader.dip]
2022-09-16 fixed usb issue, cleaned up routing
    [Core_v1.dch, Core_v1.dip]
2022-09-23 For some reason the loadswitch needs a dedicated pulldown
    [Core_v1.dch, Core_v1.dip]
2022-09-28 Pressure sensor removed, humidity replaced
    [Core_v1.dch, Core_v1.dip]
2023-09-18 update to diff cpu
    [Core_v2_min.dch, Core_v2_min.dip, Core_v2_rev1.dch, Core_v2_rev1.dip, MYC-Y6ULX Pin list_V13.xlsx, imximage.cfg, perip.ods]
2023-09-22 cleanup, added power button
    [Core_v2_min.dch, Core_v2_min.dip]
2023-10-08 Fix rootfs issue somehow
    missing interrupt setup was the cause
2023-10-08 Adds interrupt to m4
2023-10-08 Added ethernet, removed stlink
    [Core_v2_min.dch]
2023-10-11 cleaned up structure
    [Core_v2_min.dip]
2023-10-11 Start of the 'regular' version
    [Core_v2.dch]
2023-10-12 added filtering etc to power in
    [Core_v2.dch]
2023-10-13 integrated in core_v2
    [Core_v2_rev1.dch, Core_v2_rev1.dip]
2023-10-13 added rj45
    [Core_v2.dch]
2023-10-26 added the logger to the repo
    [powerlogger.dch, powerlogger.dip]
2023-10-26 added rtc, started layout
    [Core_v2.dch, Core_v2.dip]
2023-10-28 cleanup ethernet, changed debugport
    [Core_v2.dch]
2023-10-28 started doing layout
    [Core_v2.dip]
2023-10-29 started layout of ethernet
    [Core_v2.dch, Core_v2.dip]
2023-11-02 nearly done
    [Core_v2_mid.dch, Core_v2_mid.dip]
2023-11-04 nearly done...
    [Core_v2_mid.dch, Core_v2_mid.dip]
2023-11-09 Mainly improving via placement
    [Core_v2.dch, Core_v2.dip]
2023-11-12 Optimising the layout
    [Core_v2.dch, Core_v2.dip]
2023-11-17 cleanup powerlogger
    [powerlogger - rev1.dip, powerlogger -rev1.dch, powerlogger.dch]
2023-11-17 Fixed uart routines and general i2c timing
2023-11-17 Fixed rev label, was 1 instead of 0
    [powerlogger.dip]
2023-11-18 refactoring the filenames
    [powerlogger - rev1.dip, powerlogger -rev1.dch, powerlogger.dch, powerlogger.dip, powerlogger_rev0.dch, powerlogger_rev0.dip]
2023-11-25 Made a repo for the logger, so moved it
    [powerlogger.dch, powerlogger.dip, powerlogger_rev0.dch, powerlogger_rev0.dip]
2023-12-20 Added rj45 breakout
    [rj45.dch, rj45.dip]
2023-12-21 Added i2c6 and rtc
2023-12-21 UART4 RX to B2 from A11
2023-12-23 Fixed uart4 AF selection
2023-12-23 tsv files for programming
    [bootstages.tsv, regular.tsv]
2023-12-23 Added i2c6 and pwr_regulators
2023-12-24 uncomment dma
2023-12-25 Allow the generated devicetrees
2023-12-25 Addded sdmmc3 & i2c6
2023-12-25 Added heartbeat led
2023-12-25 Added i2c error
2023-12-26 Removed tiny
    [Core_v2_tiny.dch, Core_v2_tiny.dip]
2023-12-28 usb breakout
    [usb.dch, usb.dip]
2023-12-28 added error led
2023-12-28 Added info on dma issue
2023-12-31 added i2c5 for testing
2023-12-31 added i2c5
2023-12-31 Added internal pull up to uart4 rx for noise
2024-01-02 Posssible i2c6 fix
2024-01-02 No need for dma
2024-01-02 updated i2c issue
2024-03-28 Changed structure, maybe should have started anew.
    [Base_v1.dch, Base_v1.dip, Core_v1.dch, Core_v1.dip, Core_v2 - rev0.dch, Core_v2 - rev0.dip, Core_v2.dch, Core_v2.dip]
